ActiveSensing/General_Setup_Instructions/Ball Walking Camera Instructions/3D Printed and Manufactured Parts/8mm Ball Blower.pdf

# 8mm Ball Blower

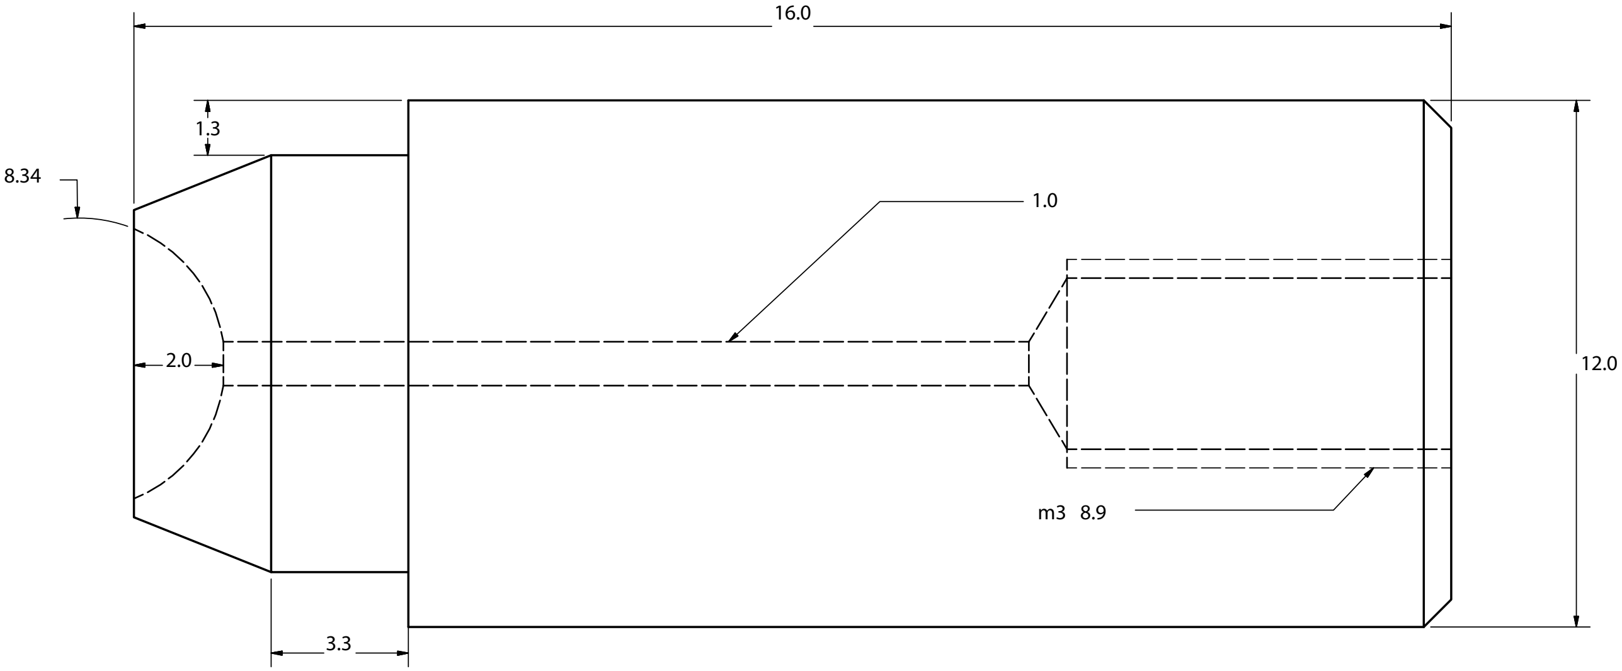
[picture p2: figure]

10.0
