ActiveSensing/General_Setup_Instructions/Full-Cone Projector Instructions/3D Printed and Manufactured Parts/100mm_FullCone_Support.stl

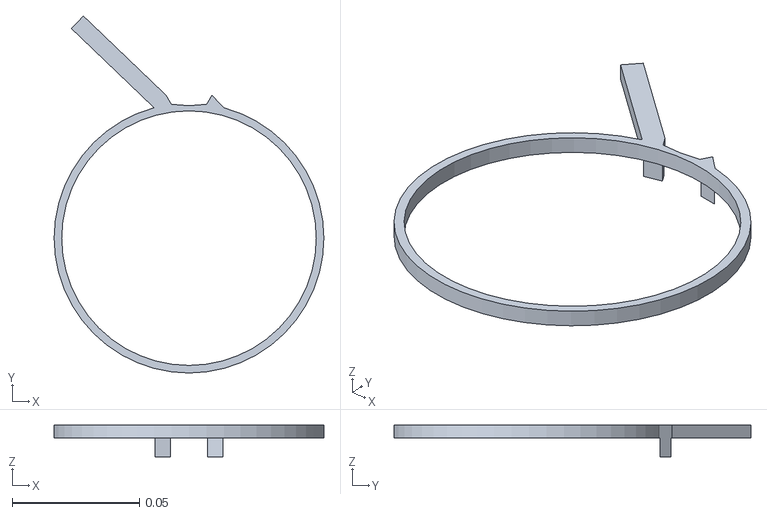
[picture p3: CAD file, 2026-08-20]
Full-Cone Projector Instructions/3D Printed and Manufactured Parts/100mm_FullCone_Support.stl
0.106 x 0.14 x 0.0125
