ActiveSensing/General_Setup_Instructions/Full-Cone Projector Instructions/3D Printed and Manufactured Parts/100mm_FullCone_Holder.stl

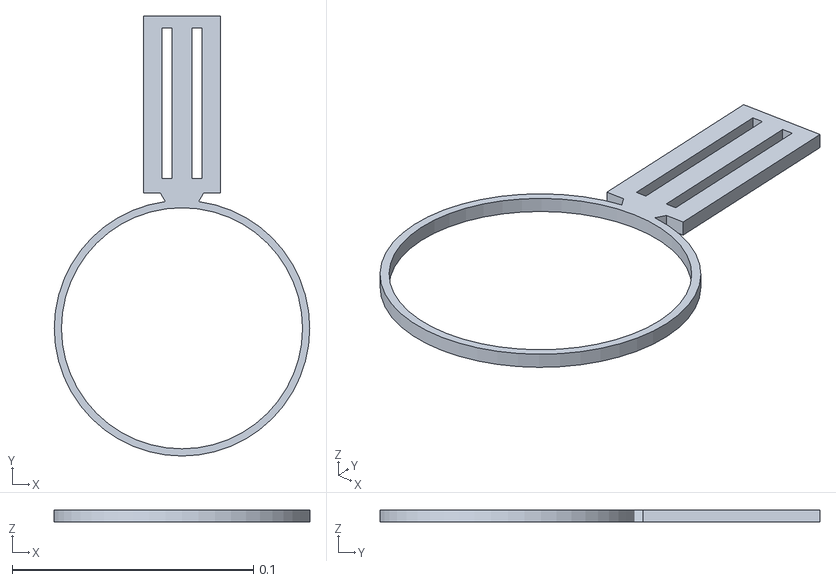
[picture p4: CAD file, 2026-08-20]
Full-Cone Projector Instructions/3D Printed and Manufactured Parts/100mm_FullCone_Holder.stl
0.106 x 0.183 x 0.005
