ActiveSensing/General_Setup_Instructions/Full-Cone Projector Instructions/3D Printed and Manufactured Parts/80mm_FullCone_HandheldSupport.stl

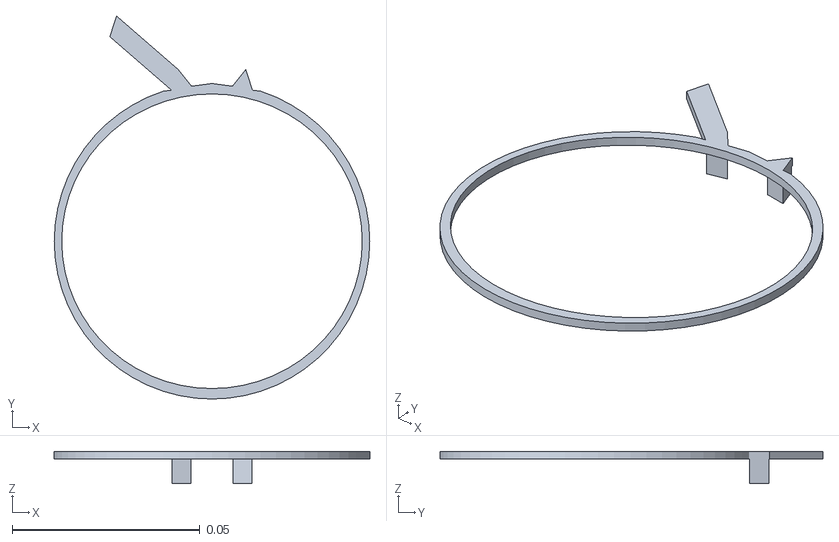
[picture p5: CAD file, 2026-08-20]
Full-Cone Projector Instructions/3D Printed and Manufactured Parts/80mm_FullCone_HandheldSupport.stl
0.084 x 0.102 x 0.00856
