ActiveSensing/General_Setup_Instructions/Full-Cone Projector Instructions/3D Printed and Manufactured Parts/80mm_FullCone_Holder.stl

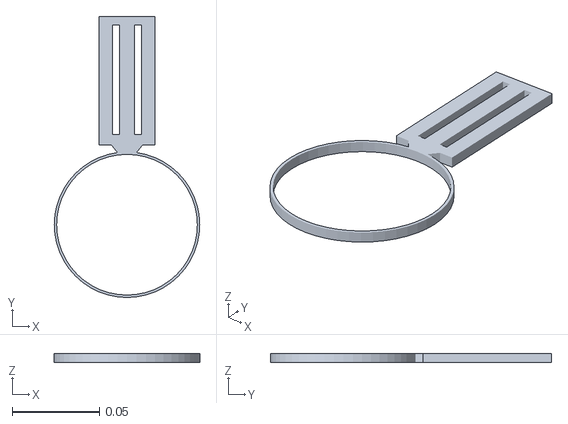
[picture p6: CAD file, 2026-08-20]
Full-Cone Projector Instructions/3D Printed and Manufactured Parts/80mm_FullCone_Holder.stl
0.0833 x 0.161 x 0.005
