ActiveSensing/General_Setup_Instructions/Ball Walking Camera Instructions/3D Printed and Manufactured Parts/BallCameraHolder_Horizontal_RC2_short_base10mm.stl

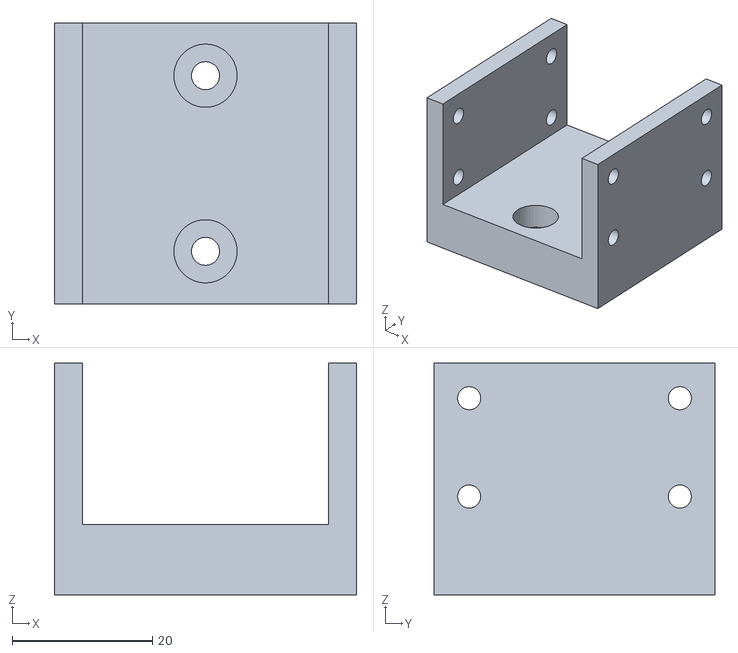
[picture p7: CAD file, 2026-10-22]
Ball Walking Camera Instructions/3D Printed and Manufactured Parts/BallCameraHolder_Horizontal_RC2_short_base10mm.stl
43.0 x 40.0 x 33.0
