ActiveSensing/General_Setup_Instructions/Ball Walking Camera Instructions/3D Printed and Manufactured Parts/Second Mirror for Flight/SecondMirrorRotor.stl

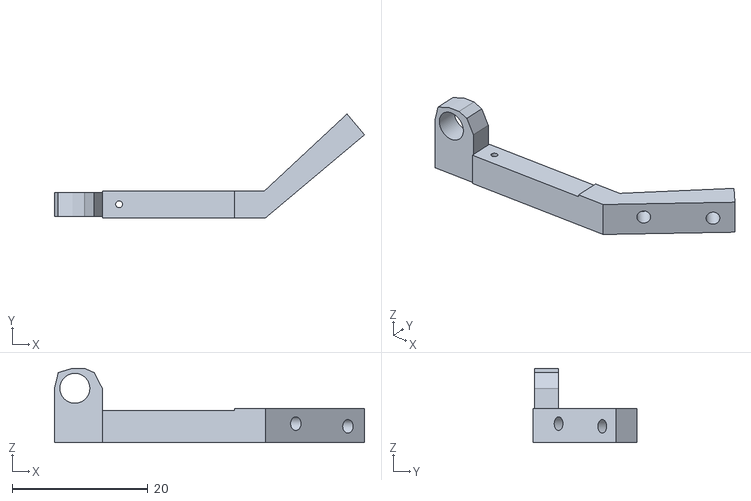
[picture p8: CAD file, 2026-02-16]
Ball Walking Camera Instructions/3D Printed and Manufactured Parts/Second Mirror for Flight/SecondMirrorRotor.stl
45.6 x 15.3 x 10.9
