ActiveSensing/General_Setup_Instructions/Full-Cone Projector Instructions/3D Printed and Manufactured Parts/80mm_ConeHandheldSupport_MagneticVersion.STEP

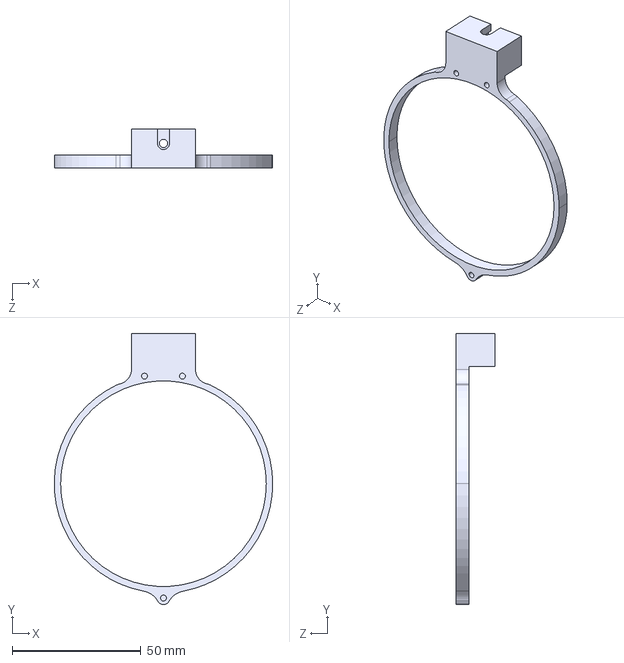
[picture p9: CAD file, 2026-10-26]
Full-Cone Projector Instructions/3D Printed and Manufactured Parts/80mm_ConeHandheldSupport_MagneticVersion.STEP
85.0 x 105.4 x 15.0 mm
