ActiveSensing/General_Setup_Instructions/Half-Cone Projector Instructions/3D Printed and Manufactured Parts/Cone Supports/80mm_HalfCone_Holder.stl

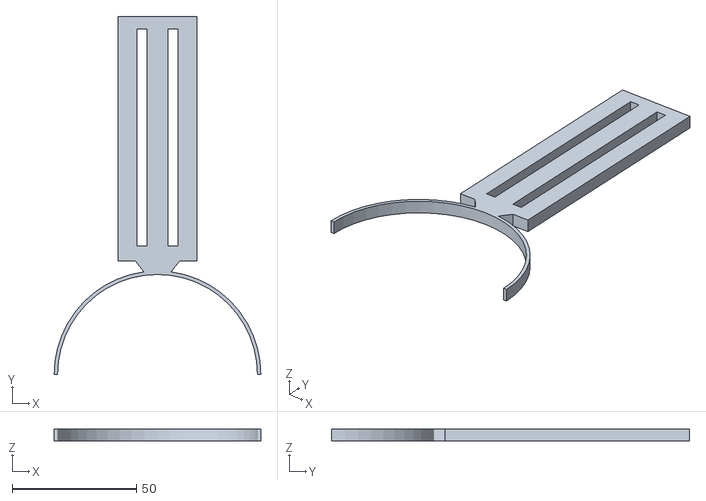
[picture p10: CAD file, 2026-03-02]
Half-Cone Projector Instructions/3D Printed and Manufactured Parts/Cone Supports/80mm_HalfCone_Holder.stl
83.3 x 144.2 x 5.00
