ActiveSensing/General_Setup_Instructions/Half-Cone Projector Instructions/3D Printed and Manufactured Parts/Photodiod Accessories/PhotoDiode_LightGuideAdaptor.stl

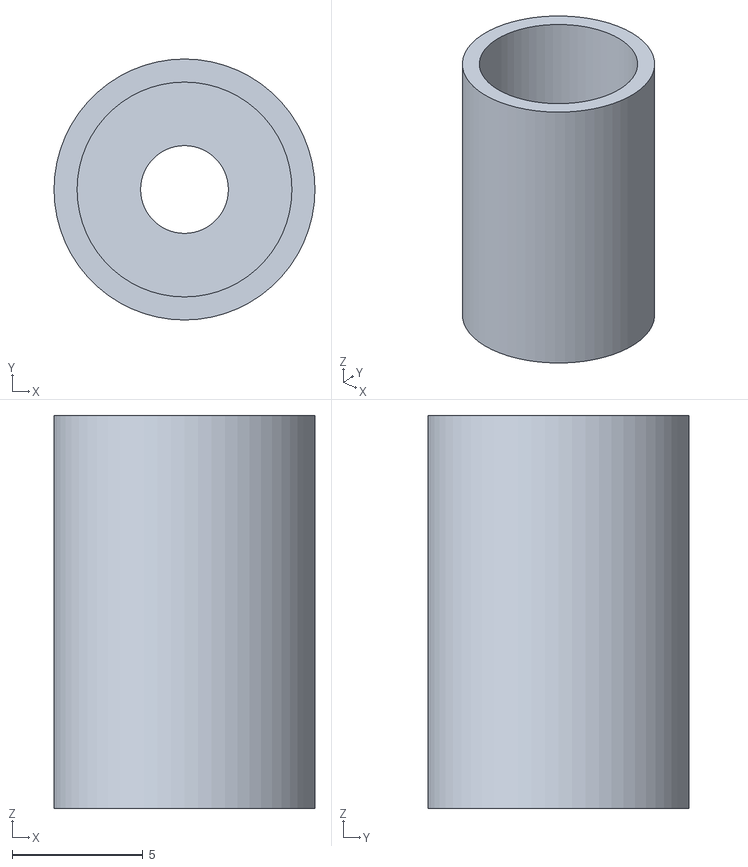
[picture p11: CAD file, 2026-03-02]
Half-Cone Projector Instructions/3D Printed and Manufactured Parts/Photodiod Accessories/PhotoDiode_LightGuideAdaptor.stl
9.96 x 9.96 x 15.0
