ActiveSensing/General_Setup_Instructions/Half-Cone Projector Instructions/3D Printed and Manufactured Parts/Projector Accessories/DLPS3010_Base_Holder.stl

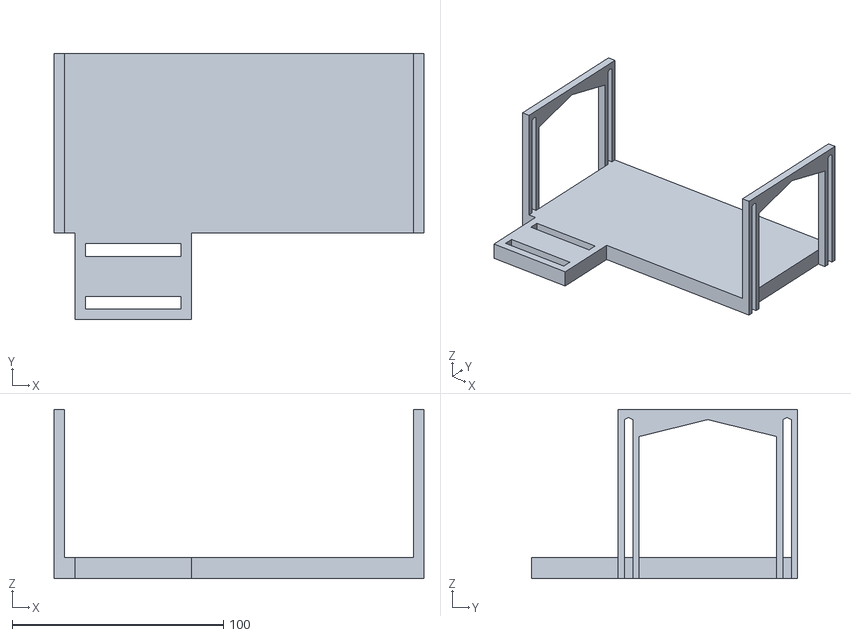
[picture p12: CAD file, 2026-03-02]
Half-Cone Projector Instructions/3D Printed and Manufactured Parts/Projector Accessories/DLPS3010_Base_Holder.stl
175.0 x 126.0 x 80.0
