ActiveSensing/General_Setup_Instructions/Half-Cone Projector Instructions/3D Printed and Manufactured Parts/Rail Carrier Accessories/RailCarier_blocker.stl

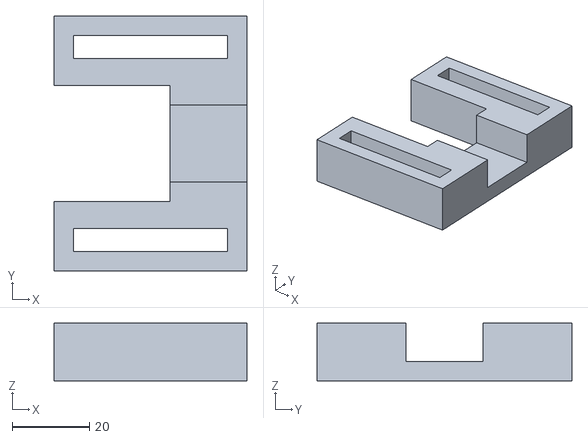
[picture p13: CAD file, 2026-03-02]
Half-Cone Projector Instructions/3D Printed and Manufactured Parts/Rail Carrier Accessories/RailCarier_blocker.stl
50.0 x 66.0 x 15.0
