ActiveSensing/General_Setup_Instructions/Half-Cone Projector Instructions/3D Printed and Manufactured Parts/TC 20mm SquaredPost Accessories/20mmSquaredPost_FlipPlatform_TipAdaptor.stl

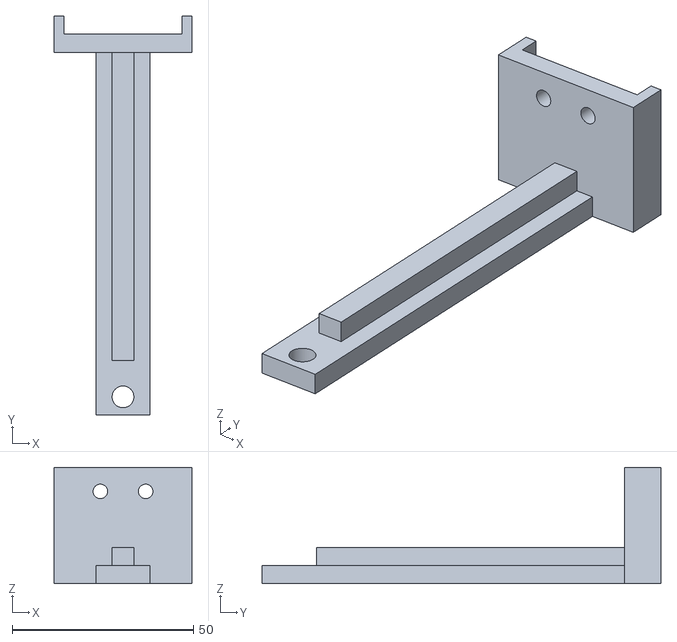
[picture p14: CAD file, 2026-03-02]
Half-Cone Projector Instructions/3D Printed and Manufactured Parts/TC 20mm SquaredPost Accessories/20mmSquaredPost_FlipPlatform_TipAdaptor.stl
38.0 x 110.0 x 32.0
