ActiveSensing/General_Setup_Instructions/Ball Walking Camera Instructions/3D Printed and Manufactured Parts/BallCameraHolder_Horizontal_RC2_short_base6mm.stl

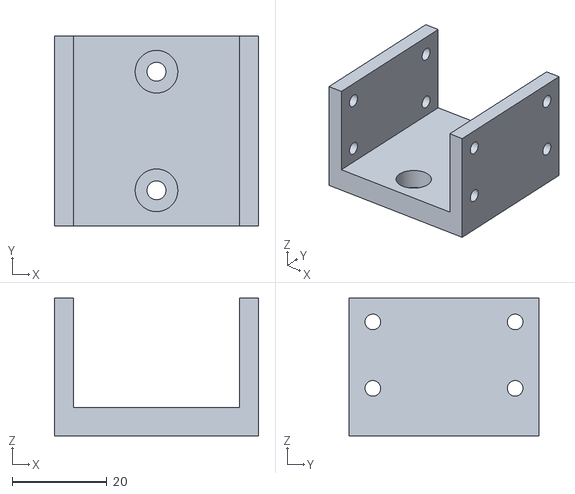
[picture p15: CAD file, 2026-10-22]
Ball Walking Camera Instructions/3D Printed and Manufactured Parts/BallCameraHolder_Horizontal_RC2_short_base6mm.stl
43.0 x 40.0 x 29.0
