ActiveSensing/General_Setup_Instructions/Ball Walking Camera Instructions/3D Printed and Manufactured Parts/Second Mirror for Flight/SecondMirrorHolder.stl

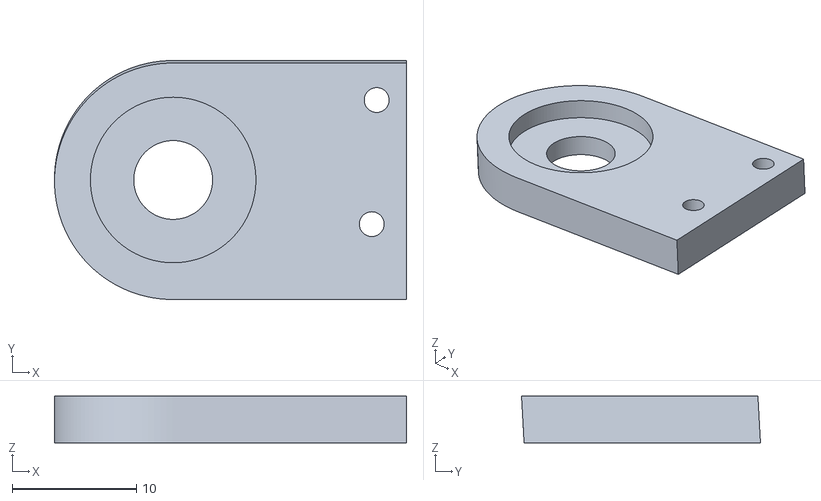
[picture p16: CAD file, 2026-02-16]
Ball Walking Camera Instructions/3D Printed and Manufactured Parts/Second Mirror for Flight/SecondMirrorHolder.stl
28.4 x 19.3 x 3.75
