ActiveSensing/General_Setup_Instructions/Full-Cone Projector Instructions/3D Printed and Manufactured Parts/80mm_ConeHolder_MagneticVersion.STEP.STEP

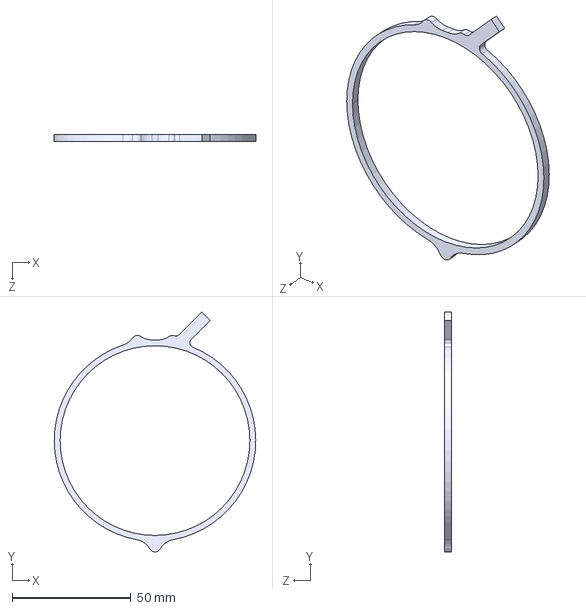
[picture p17: CAD file, 2026-10-26]
Full-Cone Projector Instructions/3D Printed and Manufactured Parts/80mm_ConeHolder_MagneticVersion.STEP.STEP
85.0 x 101.2 x 3.00 mm
