ActiveSensing/General_Setup_Instructions/Half-Cone Projector Instructions/3D Printed and Manufactured Parts/Cone Supports/80mm_HalfCone_HandeldSupport.stl

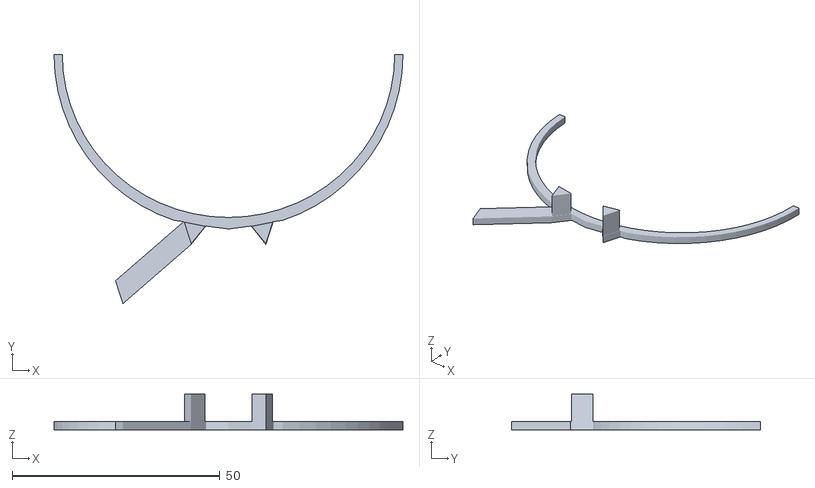
[picture p18: CAD file, 2026-03-02]
Half-Cone Projector Instructions/3D Printed and Manufactured Parts/Cone Supports/80mm_HalfCone_HandeldSupport.stl
84.0 x 60.0 x 8.56
