ActiveSensing/General_Setup_Instructions/Half-Cone Projector Instructions/3D Printed and Manufactured Parts/Projector Accessories/Projector_PhotoDiod_Holder.stl

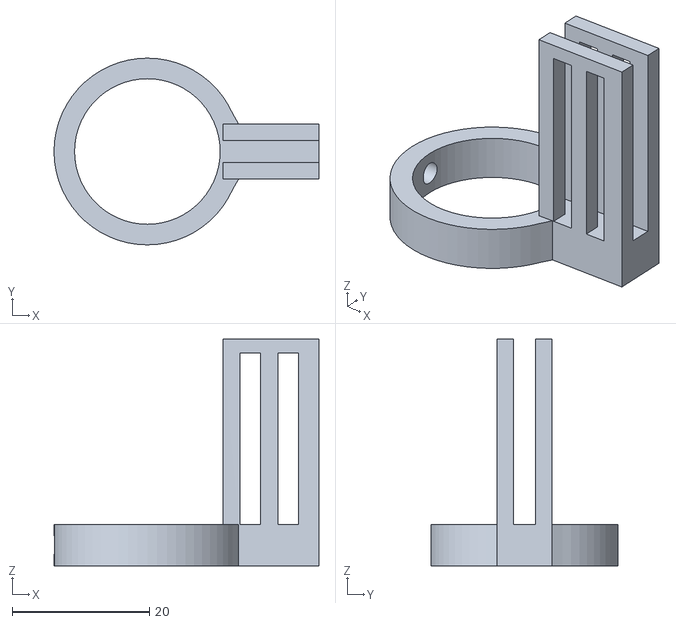
[picture p19: CAD file, 2026-03-02]
Half-Cone Projector Instructions/3D Printed and Manufactured Parts/Projector Accessories/Projector_PhotoDiod_Holder.stl
38.6 x 27.2 x 33.0
