ActiveSensing/General_Setup_Instructions/Half-Cone Projector Instructions/3D Printed and Manufactured Parts/Rail Carrier Accessories/RailCarrier_FlipingPlatform_Adaptor.stl

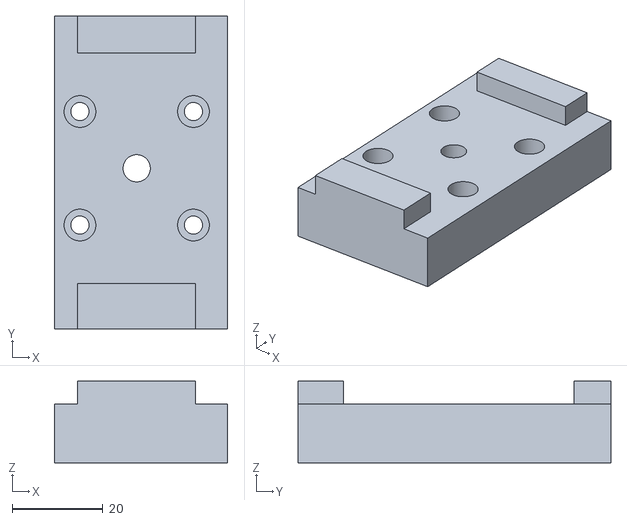
[picture p20: CAD file, 2026-03-02]
Half-Cone Projector Instructions/3D Printed and Manufactured Parts/Rail Carrier Accessories/RailCarrier_FlipingPlatform_Adaptor.stl
38.1 x 68.9 x 18.0
