ActiveSensing/General_Setup_Instructions/Half-Cone Projector Instructions/3D Printed and Manufactured Parts/TC 20mm SquaredPost Accessories/20mmSquaredPost_FlipPlatform_FlatAdaptor.stl

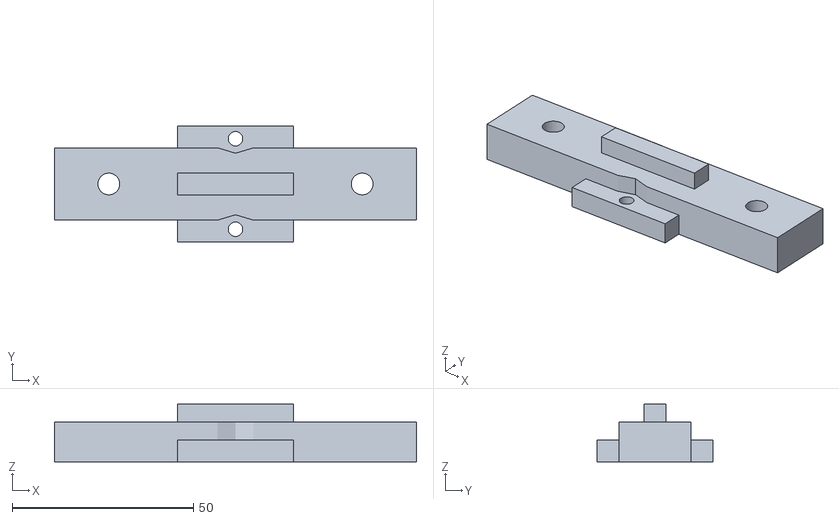
[picture p21: CAD file, 2026-03-02]
Half-Cone Projector Instructions/3D Printed and Manufactured Parts/TC 20mm SquaredPost Accessories/20mmSquaredPost_FlipPlatform_FlatAdaptor.stl
100.0 x 32.0 x 16.0
