ActiveSensing/General_Setup_Instructions/Ball Walking Camera Instructions/3D Printed and Manufactured Parts/BallCameraHolder_Horizontal_RC2_with_M6_holes.stl

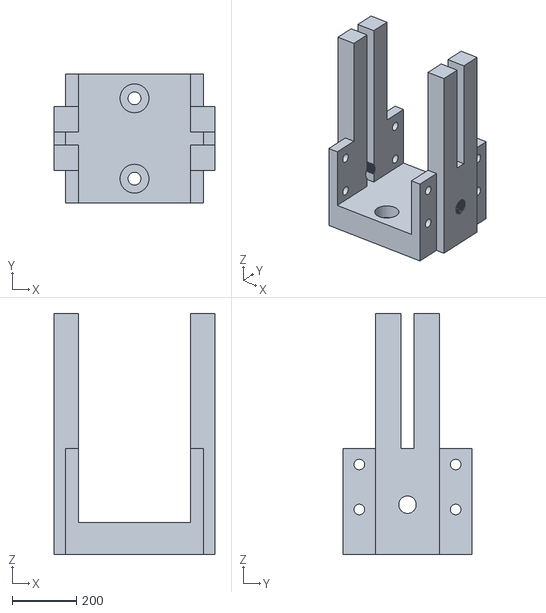
[picture p22: CAD file, 2026-08-20]
Ball Walking Camera Instructions/3D Printed and Manufactured Parts/BallCameraHolder_Horizontal_RC2_with_M6_holes.stl
500.0 x 400.0 x 750.0
