ActiveSensing/General_Setup_Instructions/Ball Walking Camera Instructions/3D Printed and Manufactured Parts/Second Mirror for Flight/SecondMirrorStator.stl

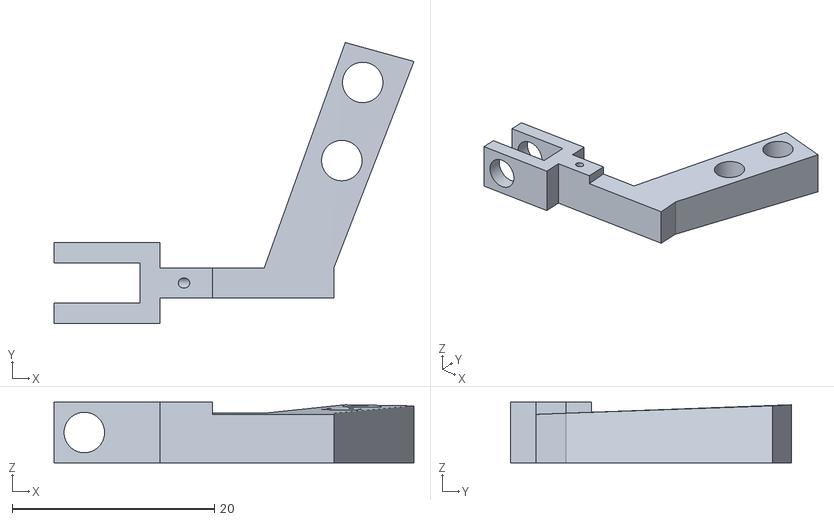
[picture p23: CAD file, 2026-02-16]
Ball Walking Camera Instructions/3D Printed and Manufactured Parts/Second Mirror for Flight/SecondMirrorStator.stl
35.6 x 27.8 x 6.00
