ActiveSensing/General_Setup_Instructions/Half-Cone Projector Instructions/3D Printed and Manufactured Parts/Projector Accessories/DLP3010_Base.stl

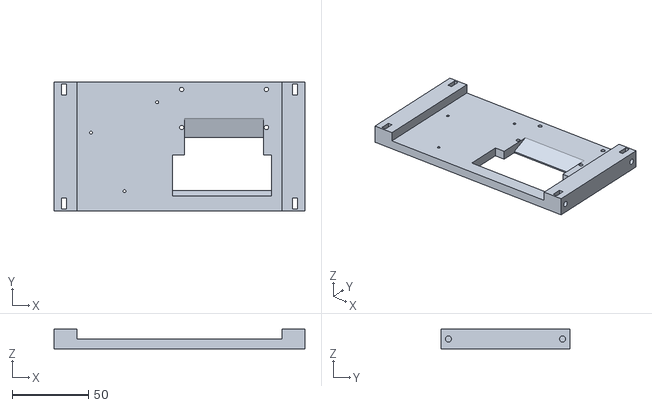
[picture p24: CAD file, 2026-03-02]
Half-Cone Projector Instructions/3D Printed and Manufactured Parts/Projector Accessories/DLP3010_Base.stl
165.0 x 85.0 x 13.0
