ActiveSensing/General_Setup_Instructions/Half-Cone Projector Instructions/3D Printed and Manufactured Parts/TC 20mm SquaredPost Accessories/20mmSquaredPost_Extensor.stl

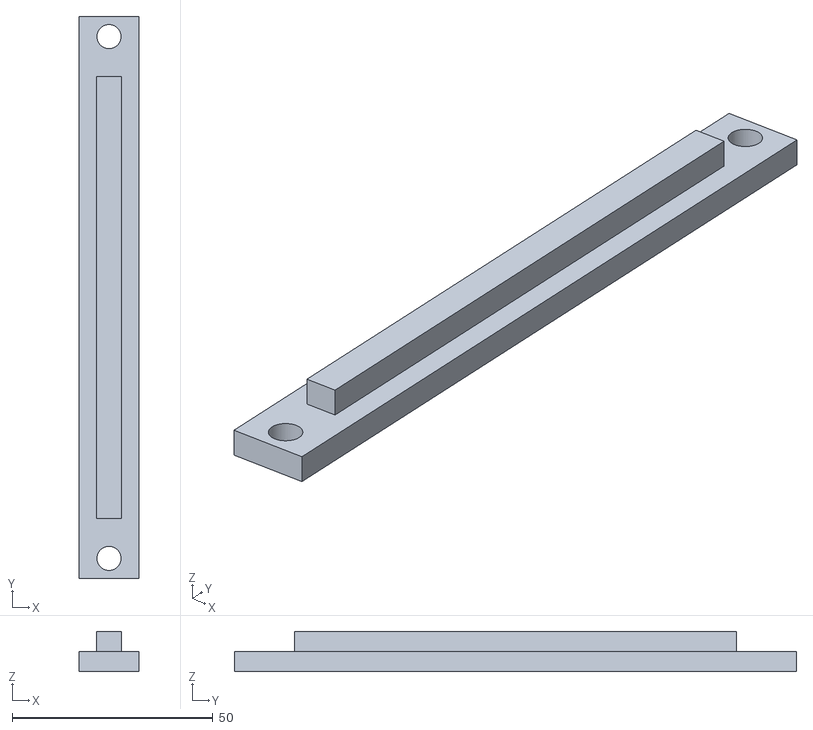
[picture p25: CAD file, 2026-03-02]
Half-Cone Projector Instructions/3D Printed and Manufactured Parts/TC 20mm SquaredPost Accessories/20mmSquaredPost_Extensor.stl
15.0 x 140.0 x 10.0
