ActiveSensing/General_Setup_Instructions/Ball Walking Camera Instructions/3D Printed and Manufactured Parts/BallCameraHolder_VerticalRC2_Aligned.stl

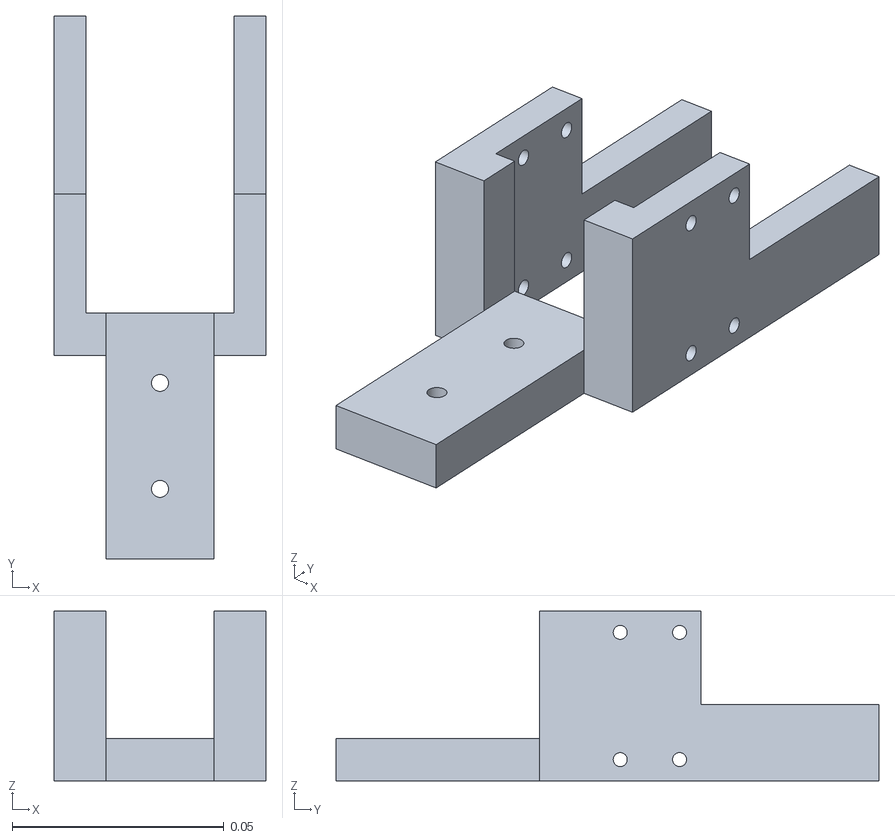
[picture p26: CAD file, 2026-02-18]
Ball Walking Camera Instructions/3D Printed and Manufactured Parts/BallCameraHolder_VerticalRC2_Aligned.stl
0.05 x 0.128 x 0.04
