ActiveSensing/General_Setup_Instructions/Half-Cone Projector Instructions/3D Printed and Manufactured Parts/TC 20mm SquaredPost Accessories/20mmSquaredPost_FlipPlatform_SidedAdaptor.stl

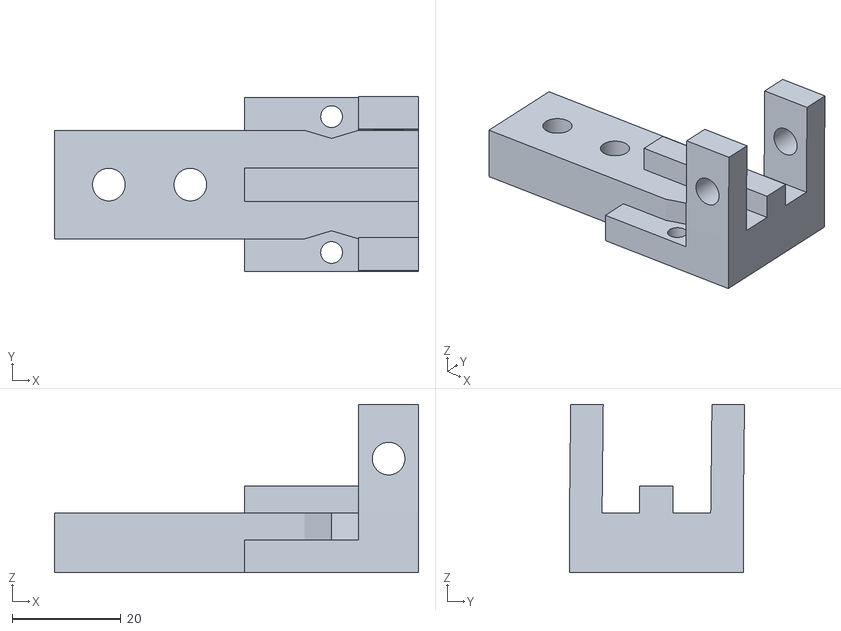
[picture p27: CAD file, 2026-03-02]
Half-Cone Projector Instructions/3D Printed and Manufactured Parts/TC 20mm SquaredPost Accessories/20mmSquaredPost_FlipPlatform_SidedAdaptor.stl
67.0 x 32.2 x 31.0
