ActiveSensing/General_Setup_Instructions/Ball Walking Camera Instructions/3D Printed and Manufactured Parts/Camera_Micromanipulator_Adaptor_Sided.stl

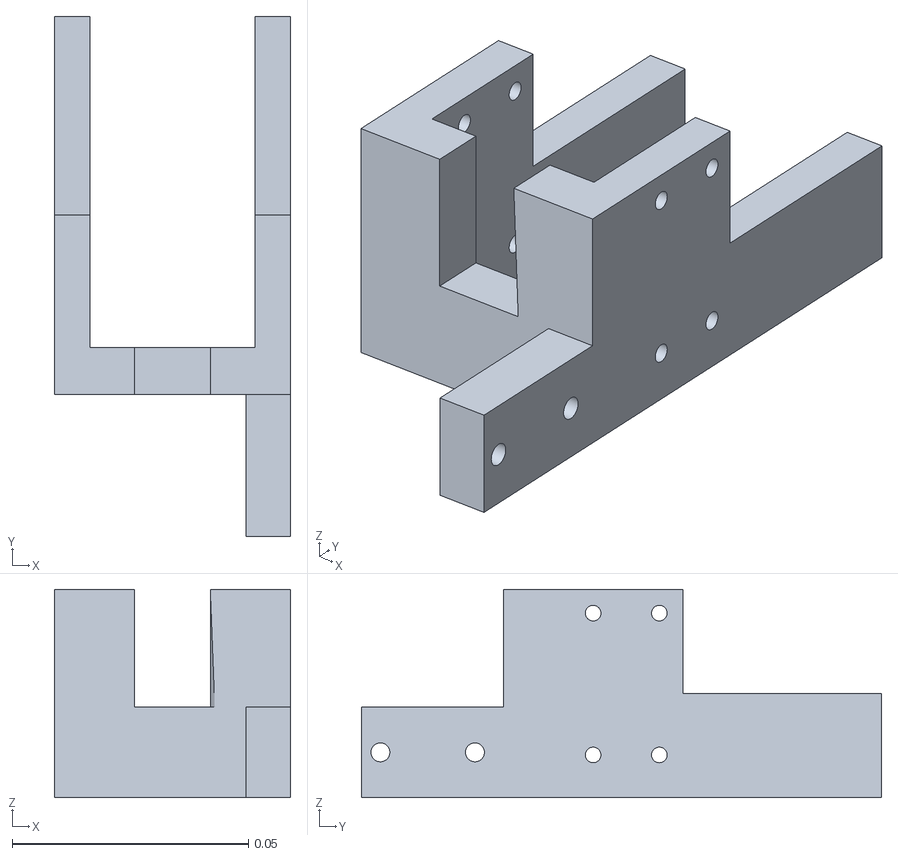
[picture p28: CAD file, 2026-02-18]
Ball Walking Camera Instructions/3D Printed and Manufactured Parts/Camera_Micromanipulator_Adaptor_Sided.stl
0.05 x 0.11 x 0.044
