ActiveSensing/General_Setup_Instructions/Half-Cone Projector Instructions/3D Printed and Manufactured Parts/TC 20mm SquaredPost Accessories/20mmSquaredPost_FlipPlatform_BaseAdaptor.stl

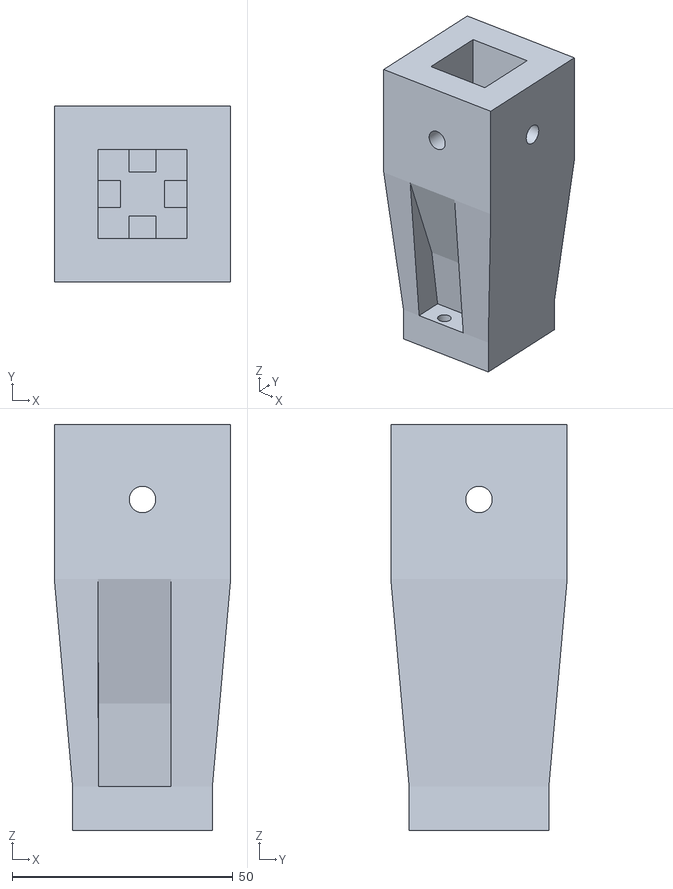
[picture p29: CAD file, 2026-03-02]
Half-Cone Projector Instructions/3D Printed and Manufactured Parts/TC 20mm SquaredPost Accessories/20mmSquaredPost_FlipPlatform_BaseAdaptor.stl
40.0 x 40.0 x 92.1
