ActiveSensing/General_Setup_Instructions/Ball Walking Camera Instructions/3D Printed and Manufactured Parts/BallCamera_VerticalRail_RC2.stl

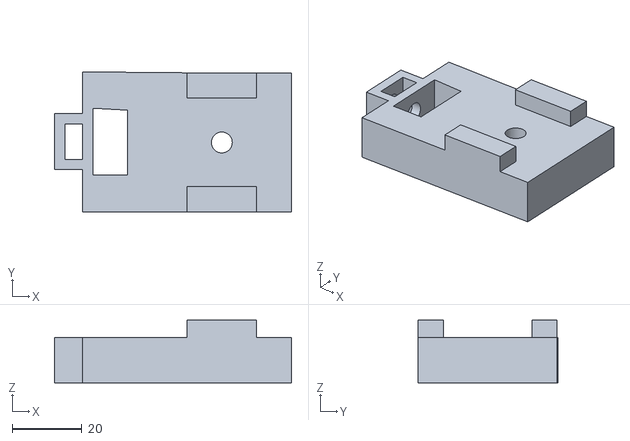
[picture p30: CAD file, 2026-02-18]
Ball Walking Camera Instructions/3D Printed and Manufactured Parts/BallCamera_VerticalRail_RC2.stl
68.0 x 40.3 x 18.0
