ActiveSensing/General_Setup_Instructions/Full-Cone Projector Instructions/3D Printed and Manufactured Parts/DLP3010_base.stl

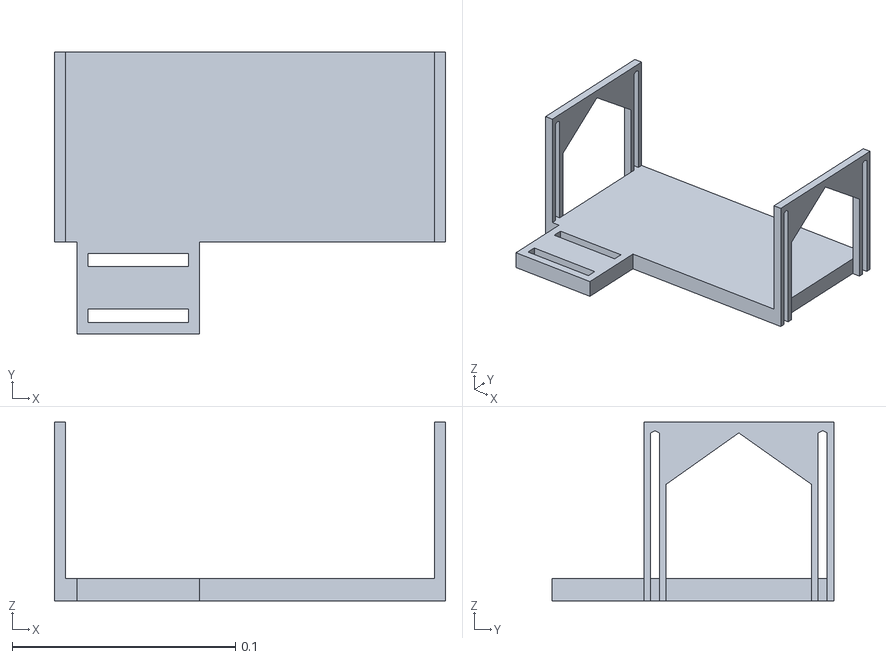
[picture p31: CAD file, 2026-08-20]
Full-Cone Projector Instructions/3D Printed and Manufactured Parts/DLP3010_base.stl
0.175 x 0.126 x 0.08
