ActiveSensing/General_Setup_Instructions/Ball Walking Camera Instructions/3D Printed and Manufactured Parts/BallCameraHolder_Horizontal_RC2.stl

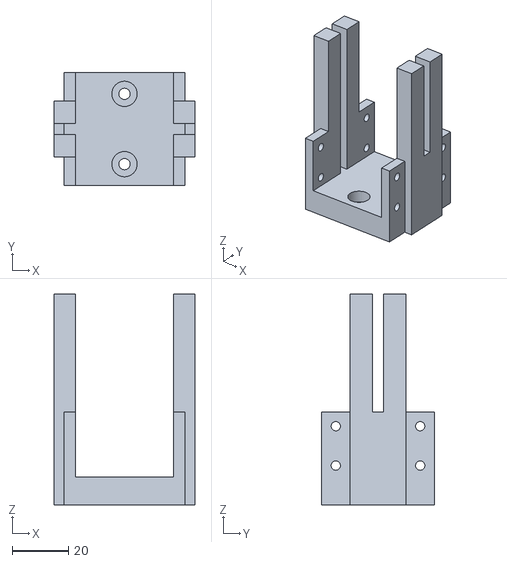
[picture p32: CAD file, 2026-02-18]
Ball Walking Camera Instructions/3D Printed and Manufactured Parts/BallCameraHolder_Horizontal_RC2.stl
50.0 x 40.0 x 75.0
