ActiveSensing/General_Setup_Instructions/Full-Cone Projector Instructions/3D Printed and Manufactured Parts/DLP3010_NoOffset_LensSpacer.stl

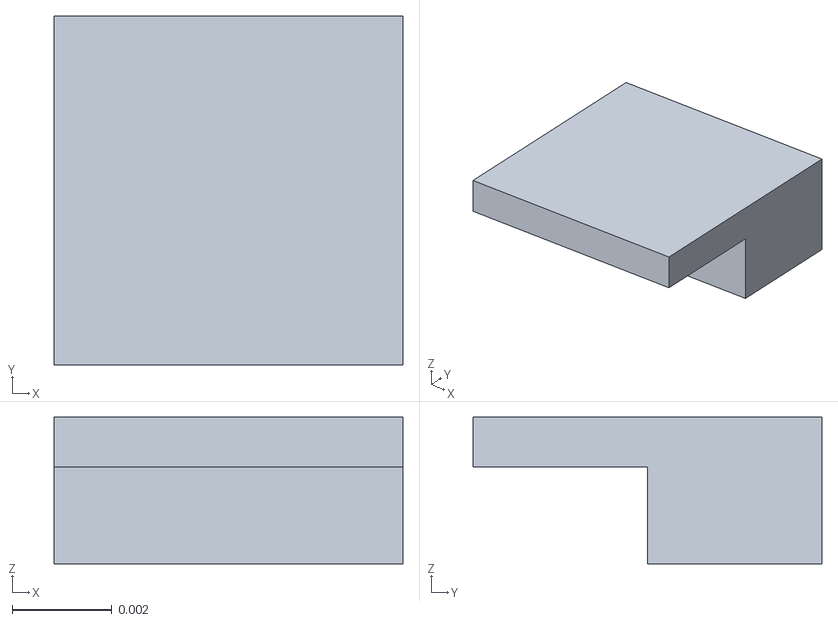
[picture p33: CAD file, 2026-08-20]
Full-Cone Projector Instructions/3D Printed and Manufactured Parts/DLP3010_NoOffset_LensSpacer.stl
0.007 x 0.007 x 0.00294
