ActiveSensing/General_Setup_Instructions/Ball Walking Camera Instructions/3D Printed and Manufactured Parts/BallCameraHolder_VerticalRC2_Sided.stl

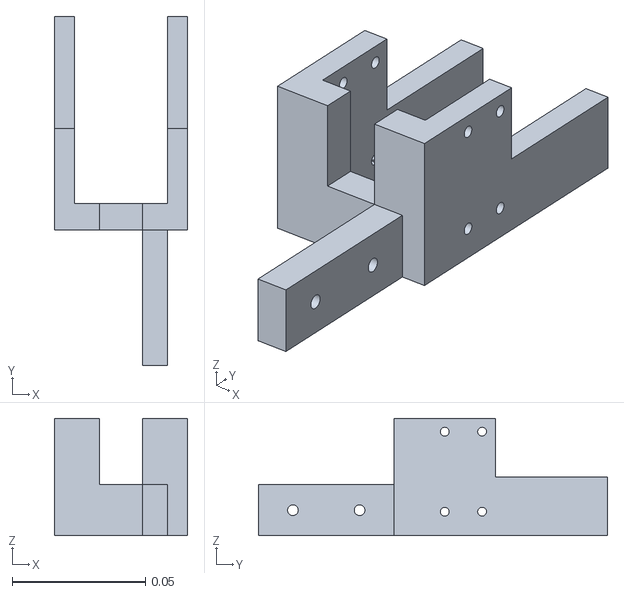
[picture p34: CAD file, 2026-02-18]
Ball Walking Camera Instructions/3D Printed and Manufactured Parts/BallCameraHolder_VerticalRC2_Sided.stl
0.05 x 0.131 x 0.044
