ActiveSensing/General_Setup_Instructions/Ball Walking Camera Instructions/3D Printed and Manufactured Parts/Yoni_BallHolder_100Deg.stl

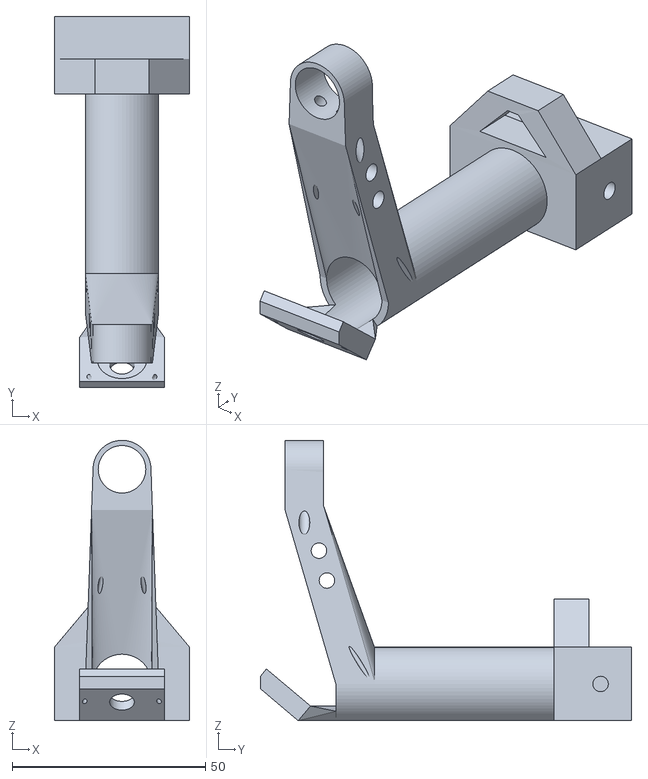
[picture p35: CAD file, 2026-02-16]
Ball Walking Camera Instructions/3D Printed and Manufactured Parts/Yoni_BallHolder_100Deg.stl
35.0 x 96.0 x 72.5
