ActiveSensing/General_Setup_Instructions/Full-Cone Projector Instructions/3D Printed and Manufactured Parts/DLP3010_base_Holder.stl

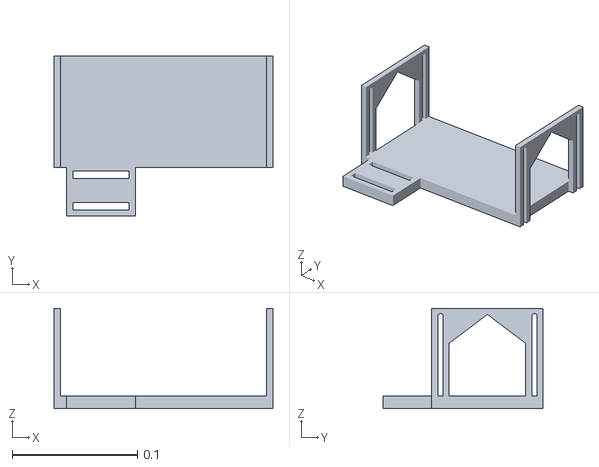
[picture p36: CAD file, 2026-08-20]
Full-Cone Projector Instructions/3D Printed and Manufactured Parts/DLP3010_base_Holder.stl
0.175 x 0.128 x 0.08
