ActiveSensing/General_Setup_Instructions/(list of files, cad)

Other CAD files:
Ball Walking Camera Instructions/3D Printed and Manufactured Parts/BallCameraHolder_Horizontal_RC2_short.f3d
Ball Walking Camera Instructions/3D Printed and Manufactured Parts/BallCameraHolder_Horizontal_RC2_short_base6mm.f3d
Ball Walking Camera Instructions/3D Printed and Manufactured Parts/BallCameraHolder_Horizontal_RC2_with_M6_holes.f3d
Ball Walking Camera Instructions/3D Printed and Manufactured Parts/BallCameraHolders.blend
Ball Walking Camera Instructions/3D Printed and Manufactured Parts/BallCamera_VerticalRail_RC2.blend
Ball Walking Camera Instructions/3D Printed and Manufactured Parts/Yoni_BallHolder_100Deg.blend
Full-Cone Projector Instructions/3D Printed and Manufactured Parts/100mm_FullCone_Support.blend
Full-Cone Projector Instructions/3D Printed and Manufactured Parts/80mm_FullCone_Support.blend
Half-Cone Projector Instructions/3D Printed and Manufactured Parts/Cone Supports/80mm_HalfCone_Support.blend
Half-Cone Projector Instructions/3D Printed and Manufactured Parts/Photodiod Accessories/PhotoDiod_LightGuideAdaptor.blend
Half-Cone Projector Instructions/3D Printed and Manufactured Parts/Projector Accessories/DLP3010_base.blend
Half-Cone Projector Instructions/3D Printed and Manufactured Parts/Projector Accessories/Projector_PhotoDiod_Holder.blend
Half-Cone Projector Instructions/3D Printed and Manufactured Parts/Rail Carrier Accessories/RailCarier_blocker.blend
Half-Cone Projector Instructions/3D Printed and Manufactured Parts/Rail Carrier Accessories/RailCarrier_Rail_FlipingPlatform_Adaptor.blend
Half-Cone Projector Instructions/3D Printed and Manufactured Parts/TC 20mm SquaredPost Accessories/20mmSquaredPost_Extensor.blend
Half-Cone Projector Instructions/3D Printed and Manufactured Parts/TC 20mm SquaredPost Accessories/20mmSquaredPost_FlipPlatform_BaseAdaptor.blend
Half-Cone Projector Instructions/3D Printed and Manufactured Parts/TC 20mm SquaredPost Accessories/20mmSquaredPost_FlipPlatform_FlatAdaptor.blend
Half-Cone Projector Instructions/3D Printed and Manufactured Parts/TC 20mm SquaredPost Accessories/20mmSquaredPost_FlipPlatform_SidedAdaptor.blend
Half-Cone Projector Instructions/3D Printed and Manufactured Parts/TC 20mm SquaredPost Accessories/20mmSquaredPost_FlipPlatform_TipAdaptor.blend
