ActiveSensing/General_Setup_Instructions/Half-Cone Projector Instructions/Cone_Cutout_Generator/cone-patterns.html

Cone Pattern Templates - Print at 100% Printer Scale

Rotate Dims Cone cutting pattern calculator profile diagram

Top Width
Base Width
Height
? Show Dimensions on template, rounded to selected precision Dims
Precision
? Draw diagram at 100% scale to print and use as template. Disabled if template over A0 size. If not Full Scale, check Dimensions to label diagram Full Scale
? Add tab to overlap and join template edges. (Only with full Template - not segments) Join Tab
? Show Template bounding rectangle with dimensions Bounding
? For large templates - divide into multiple IDENTICAL smaller segments for easier printing Segments

Horizontal Markings

None

Holes

Lines

Custom Rows

Even Rows

?
Enter the diameter of the line

Line Diameter

Rows

Hole Type
Hole Diameter

Holes/Row

Vertical Columns

Text
Remove Template Border
Fonts
? Add 50 Google Web Fonts. After fonts have loaded, check 'Text' to add text to template, then click 'Fonts' dropdown to select and use keyboard cursor keys to cycle through and examine fonts. ? Click Choose Font (https://fonts.google.com/) to view available Google fonts, then hit and enter desired font name to load. Choose Font (https://fonts.google.com/) ? Search for 'Download Fonts' to choose and download a font, then browse to file and load font. (filetypes .ttf, .otf or .woff) Font from File
Bold Outline Invert Colour Mirror
↑ ↓
← →
Size
Top Base Height Letter or A4 Landscape

Cone pattern full scale cutting template

### Right Click image and Choose Save image as... to download Full Scale SVG

To Top ↑

Click and drag 3D Model to re-orient. Rotate ↔ Rotate ↕

Large Cone Layout For very large cones (base or height over 600), or when Full Scale is un-checked (diagram is not Full Scale), check Dimensions to show correct measurements to mark out cone. Volume Calibration See Volume Calibration Templates to mark incremental fluid volumes on cone.

Hit Diagrams to PDF (below) to create a PDF file up to paper size A0 (1189mm x 841mm) for large templates. Send to a Print Shop for plan printing, or to print a large template image over multiple pages, see Printing Tips
