ActiveSensing/General_Setup_Instructions/Ball Walking Camera Instructions/3D Printed and Manufactured Parts/8mm_Ball_Cutter.pdf

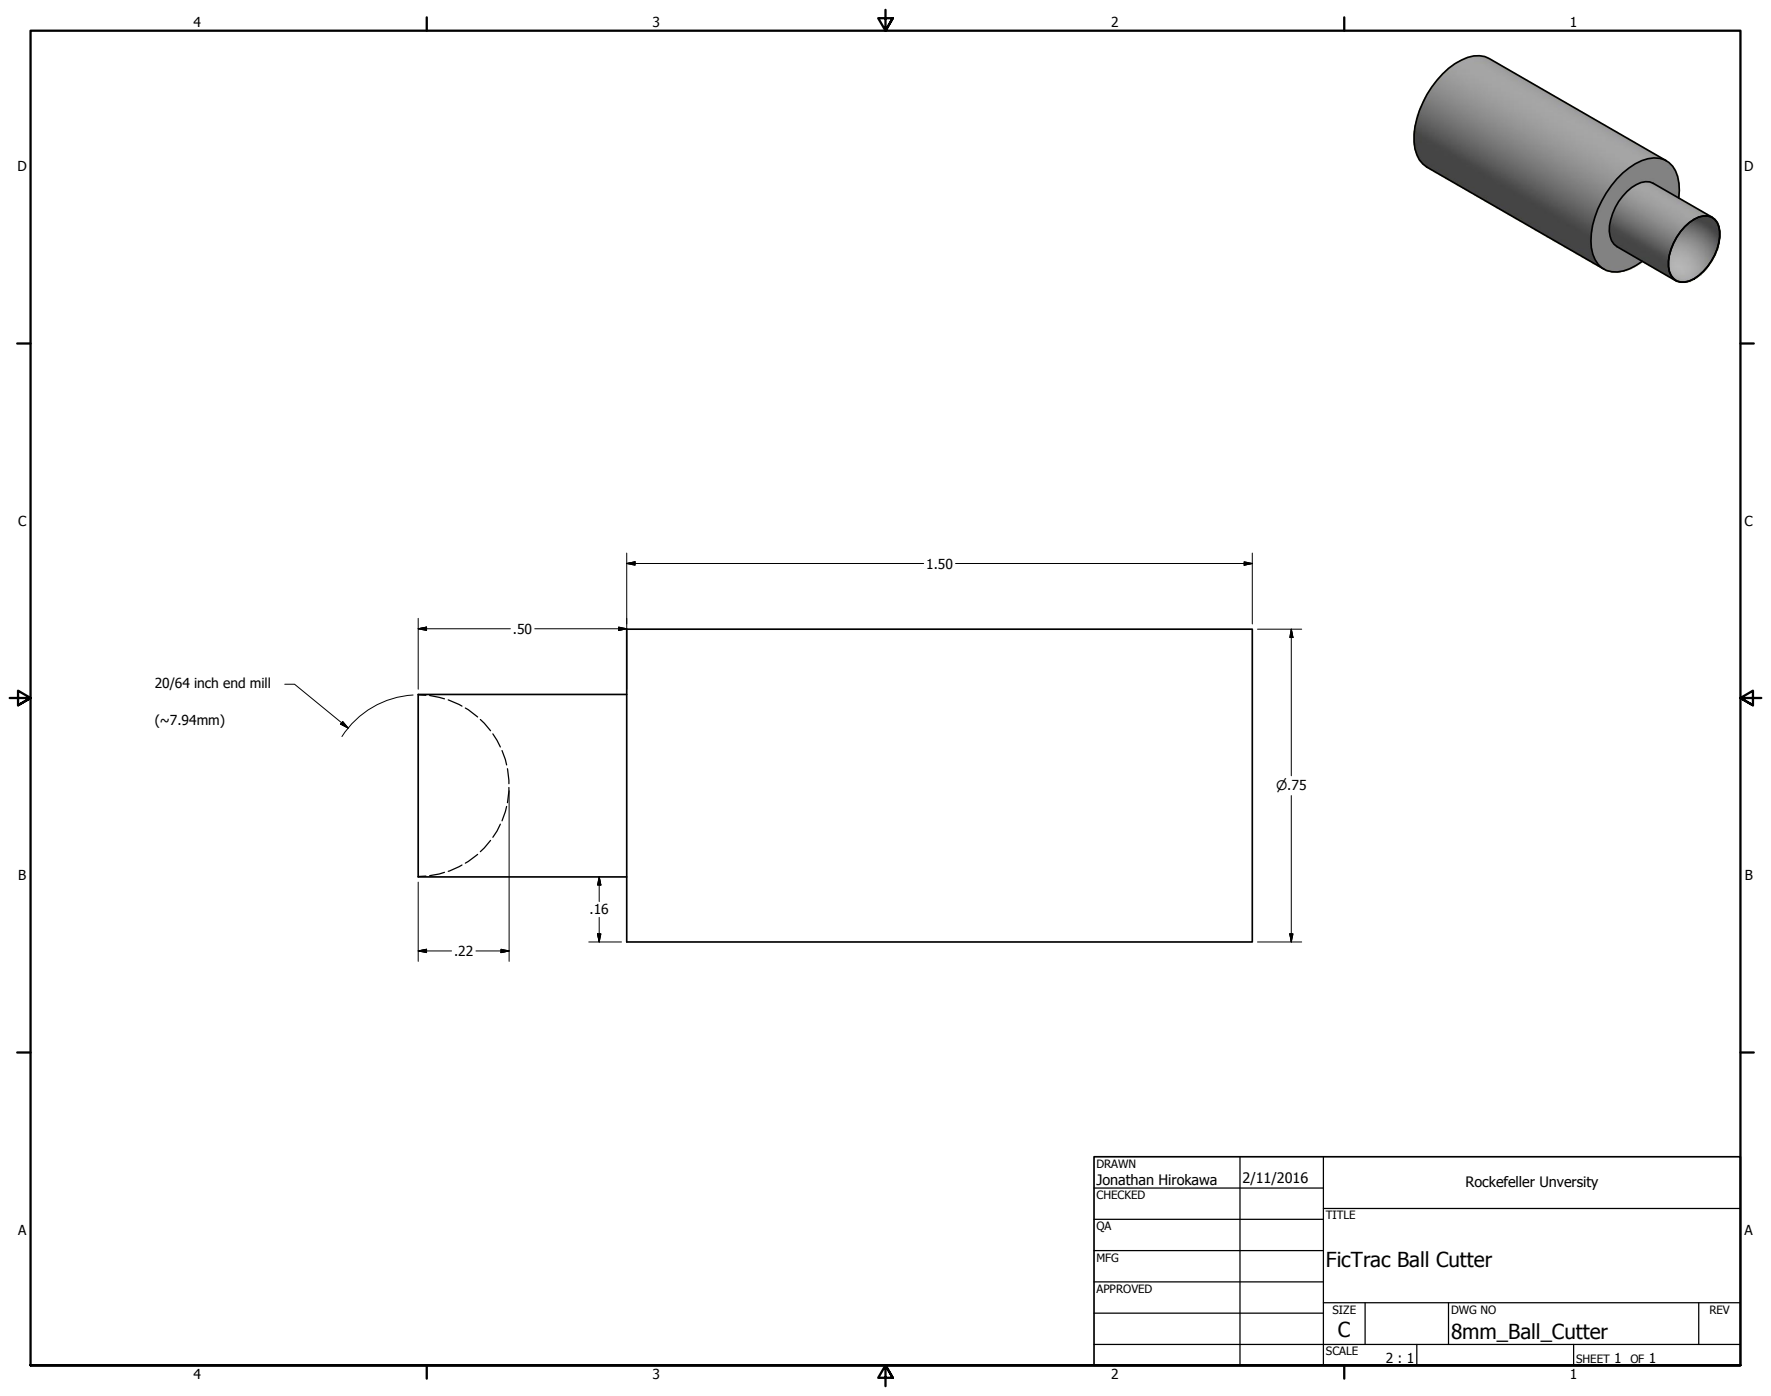
[picture p37: page 1]

20/64 inch end mill

DRAWN Jonathan Hirokawa | 2/11/2016 | Rockefeller Unversity

CHECKED

MFG

FicTrac Ball Cutter

APPROVED

SIZE C | DWG NO 8mm_Ball_Cutter | REV

SCALE 2 : 1 | | SHEET 1 OF 1
