ActiveSensing/General_Setup_Instructions/(commit log)

2026-02-16 Revise README with updated assembly steps and diagrams
    Updated assembly instructions and added schematics for the Ball Walking Camera.
2026-03-02 upload 3D files
    [20mmSquaredPost_Extensor.blend, 20mmSquaredPost_Extensor.stl, 20mmSquaredPost_FlipPlatform_BaseAdaptor.blend, 20mmSquaredPost_FlipPlatform_BaseAdaptor.stl, 20mmSquaredPost_FlipPlatform_FlatAdaptor.blend, 20mmSquaredPost_FlipPlatform_FlatAdaptor.stl, 20mmSquaredPost_FlipPlatform_SidedAdaptor.blend, 20mmSquaredPost_FlipPlatform_SidedAdaptor.stl]
2026-03-02 Update README with mounting instructions for projector
    Added detailed mounting instructions for the Half-Cone Projector, including parts list and assembly steps.
2026-03-04 import cone cutout generator
    [80mm_HalfCone_HandeldSupport.stl, 80mm_HalfCone_Holder.stl, 80mm_HalfCone_Support.blend]
2026-07-10 Add files via upload
    Modified BallCameraHolder_Horizontal_RC2, to which I added 2 M6 tapped holes - to be able to mount the camera holder directly onto a rail (Vertical Rail Adapter not needed)
    [BallCameraHolder_Horizontal_RC2_with_M6_holes.f3d, BallCameraHolder_Horizontal_RC2_with_M6_holes.stl]
2026-08-20 add 10mm cone supports
    [100mm_FullCone_Holder.stl, 100mm_FullCone_Support.blend, 100mm_FullCone_Support.stl]
2026-10-22 remade BallCameraHolders_RC2 for cone setup
    bases 10 mm and 6 mm
2026-10-26 New design with improved flattening mount
    Designed by Louis from Machine shop - October 2026
    The magnets help the two structures seamlessfly clip in place and ensure a more flat geometry.
2026-10-29 Rename PhotoDiod_LightGuideAdaptor.stl to PhotoDiode_LightGuideAdaptor.stl
    fixed typo
